citrus3000psi/DCHDMI-Hardware/MainPCB/revision 1.3a/Printing Print Schematic.pdf

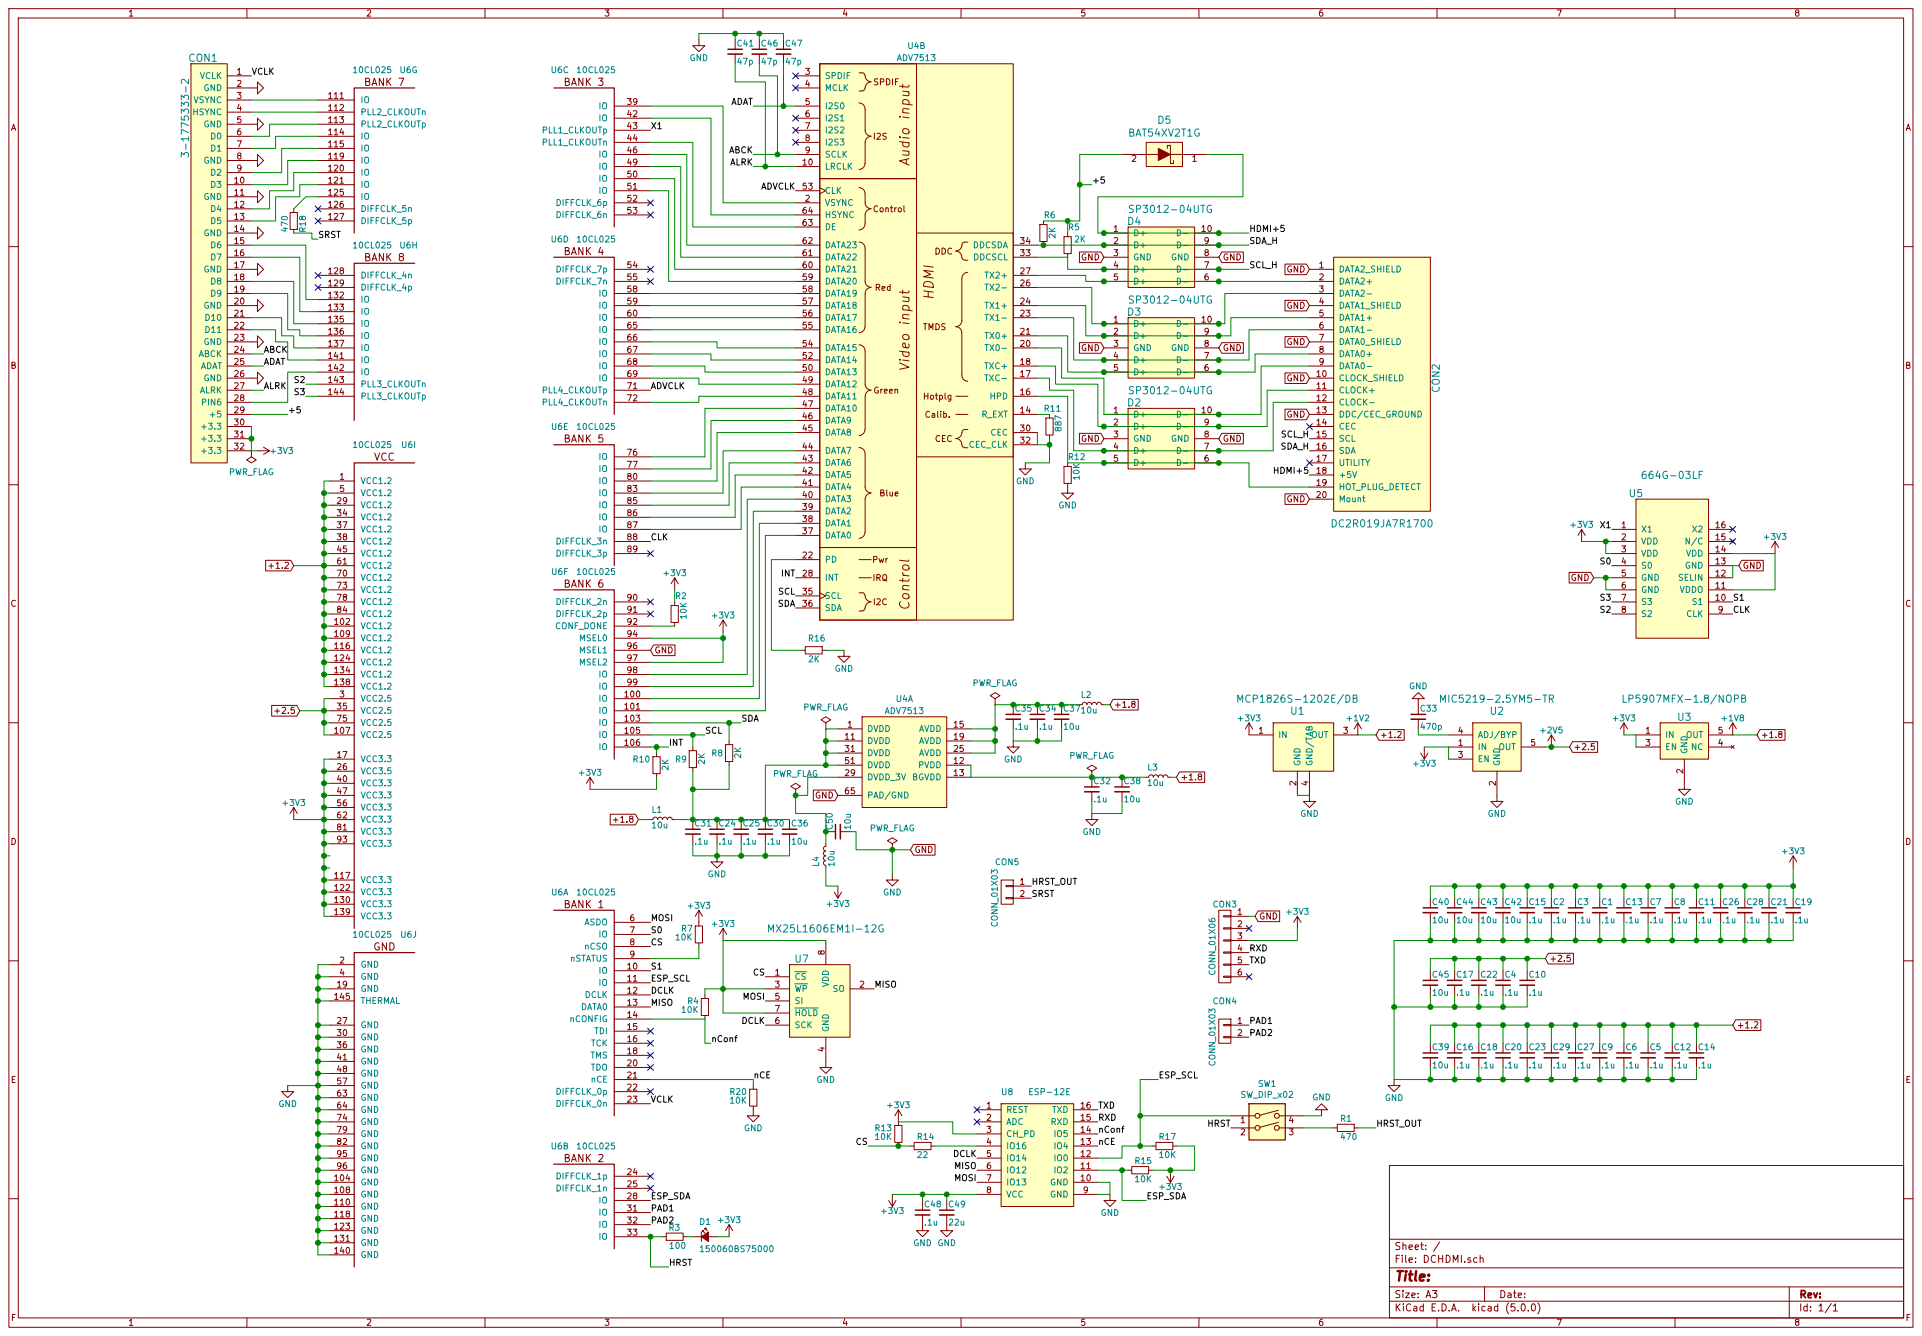
[picture p1: page 1]
