citrus3000psi/DCHDMI-Hardware/FlatFlexQSB/dcflex.kicad_pcb

## KiCad design FlatFlexQSB/dcflex.kicad_pcb (2019-04-15)

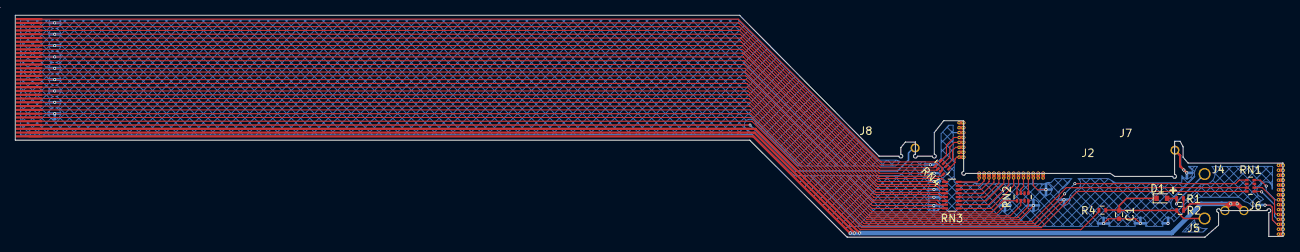
[picture p2: board dcflex.kicad_pcb from above]

Board: 2 copper layers, 167.6 x 29.3 mm, 17 parts (0 on the bottom side), 42 nets.

Parts:
C1: .1u; C_0402
D1: 1N4148WT; D_SOD-523
J1: Conn_01x32_Male; DC_FLEX_FFC_CON
J2: Conn_01x22_Male; DC_FLEX_VIDEO_HOOKUP
J3: Conn_01x15_Male; DC_FLEX_AUDIO_HOOKUP
J4, J5, J7, J8: Conn_01x01_Female; DC-PIN6-PIN7
J6: Conn_01x02_Female; DC-3v3_power
R1, R2: 47K; R_0402
R4: 1K; R_0402
RN1, RN2, RN4: R_Pack04; R_Array_Concave_4x0402
RN3: R_Pack08; R_Array_Convex_8x0602

Connections:
/+3.3: J1.30, J1.31, J1.32, J6.1, J6.2, R1.1, R2.1
/+5: J1.29, J8.1
/ABCK: J1.24, RN1.3
/ADAT: J1.25, RN1.1
/ALRK: J1.27, RN1.4
/D0: J1.6, RN4.8
/D1: J1.7, RN3.1
/D2: J1.9, RN3.2
/D3: J1.10, RN3.3
/D4: J1.12, RN3.4
/D5: J1.13, RN3.5
/D6: J1.15, RN3.6
/D7: J1.16, RN3.7
/D8: J1.18, RN3.8
/D9: J1.19, RN2.1
/D10: J1.21, RN2.2
/D11: J1.22, RN2.4
/HSYNC: J1.4, RN4.6
/VCLK: J1.1, RN4.7
/VSYNC: J1.3, RN4.5
GND: C1.2, J1.2, J1.5, J1.8, J1.11, J1.14, J1.17, J1.20, J1.23, J1.26, J2.3, J2.20, J3.3, J7.1
unnamed: C1.1, D1.1, J5.1, R2.2, R4.1
unnamed: D1.2, J4.1, R1.2
unnamed: J1.28, R4.2
unnamed: J2.4, RN2.5
unnamed: J2.5, RN2.7
unnamed: J2.6, RN2.8
unnamed: J2.7, RN3.9
unnamed: J2.8, RN3.10
unnamed: J2.9, RN3.11
unnamed: J2.10, RN3.12
unnamed: J2.11, RN3.13
unnamed: J2.12, RN3.14
unnamed: J2.13, RN3.15
unnamed: J2.14, RN3.16
unnamed: J2.15, RN4.1
unnamed: J2.17, RN4.2
unnamed: J2.18, RN4.3
unnamed: J2.19, RN4.4
unnamed: J3.4, RN1.5
unnamed: J3.5, RN1.6
unnamed: J3.8, RN1.8
