citrus3000psi/DCHDMI-Hardware/MainPCB/revision 1.2f/DCHDMI.kicad_pcb

## KiCad design MainPCB/revision 1.2f/DCHDMI.kicad_pcb (2018-09-04)

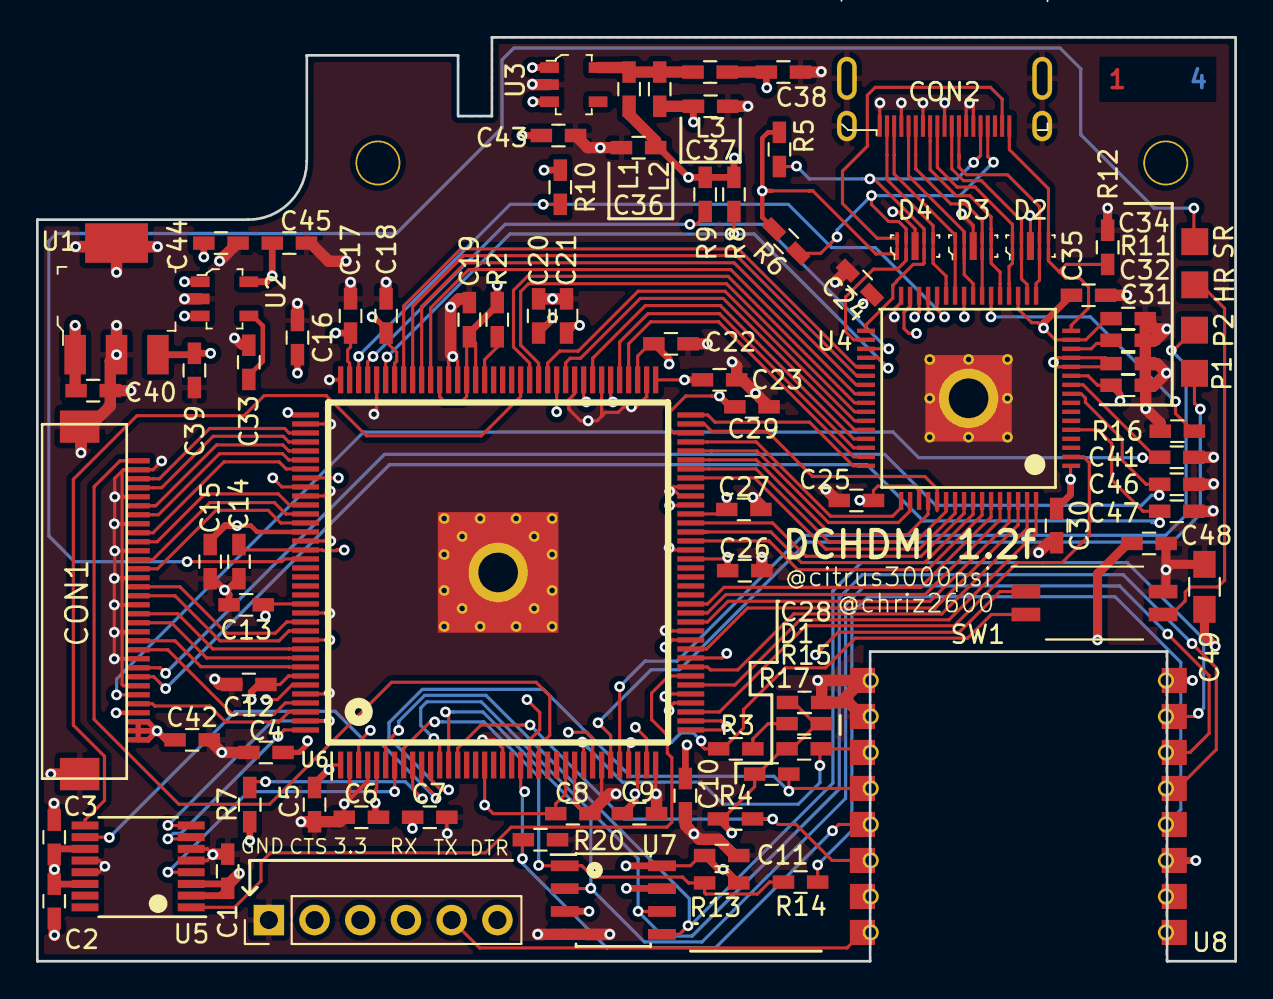
[picture p3: board DCHDMI.kicad_pcb from above]

Board: 4 copper layers, 66.6 x 51.3 mm, 87 parts (0 on the bottom side), 98 nets.

Parts:
C1, C2, C3, C4, C5, C6, C7, C8, C9, C10, C11, C12, C13, C14, C15, C16, C17, C18, C19, C20, C21, C22, C23, C24, C25, C26, C27, C28, C29, C30, C31, C32, C34, C35, C48: .1u; C_0603_HandSoldering
C33: 470p; C_0603_HandSoldering
C36, C37, C38, C39, C40, C42, C43, C44, C45: 10u; C_0603_HandSoldering
C41, C46, C47: 47p; C_0603_HandSoldering
C49: 22u; C_0805_HandSoldering
CON1: 3-1775333-2; FPC_32
CON2: DC2R019JA7R1700
CON3: CONN_01X06; Pin_Header_Straight_1x06_Pitch2.54mm
CON4, CON5: CONN_01X03; 2_Pads_Small
D1: LED; C_0603_HandSoldering
D2, D3, D4: SP3012-04UTG; UFDFN-10_2.5x1mm
L1, L2, L3: 10u; C_0603_HandSoldering
R2, R3, R4, R7, R12, R13, R15, R17, R20: 10K; C_0603_HandSoldering
R5, R6, R8, R9, R10, R16: 2K; C_0603_HandSoldering
R11: 880; C_0603_HandSoldering
R14: 22; C_0603_HandSoldering
SW1: SW_DIP_x02; SW_DIP_x2_W7.62mm_Slide_Copal_CHS-B
U1: MCP1826S-1202E/DB; SOT-223
U2: MIC5219-2.5YM5-TR; SOT-753
U3: LP5907MFX-1.8/NOPB; SOT-753
U4: ADV7513; LQFP-64_10x10mm_Pitch0.5mm_PAD
U5: 664G-03LF; TSSOP-16_4.4x5mm_Pitch0.65mm
U6: 10CL025; altera144_wcenterpad
U7: MX25L1606EM1I-12G; SOIC-8_3.9x4.9mm_Pitch1.27mm
U8: ESP-12E; ESP-12_FLAT

Connections:
+1.2: C5.1, C6.1, C9.1, C12.1, C14.1, C16.1, C18.1, C20.1, C23.1, C27.1, C29.1, C39.1, U1.3, U6.1, U6.5, U6.29, U6.34, U6.37, U6.38, U6.45, U6.61, U6.70, U6.73, U6.78, U6.84, U6.102, U6.109, U6.116, U6.124, U6.134, U6.138
+1.8: L1.1, L2.2, L3.2, U3.5
+2.5: C4.1, C10.1, C17.1, C22.1, C45.1, U2.5, U6.3, U6.35, U6.75, U6.107
+3V3: C1.1, C2.1, C3.1, C7.1, C8.1, C11.1, C13.1, C15.1, C19.1, C21.1, C26.1, C28.1, C40.1, C42.1, C43.1, C44.1, C48.1, C49.1, CON1.30, CON1.31, CON1.32, CON3.3, D1.2, R2.1, R4.1, R7.1, R10.2, R13.1, R15.1, R17.1, U1.1, U2.1, U2.3, U3.1, U3.3, U4.29, U5.2, U5.3, U5.11, U5.14, U6.17, U6.26, U6.40, U6.47, U6.56, U6.62, U6.81, U6.93, U6.94, U6.97, U6.117, U6.122, U6.130, U6.139, U7.3, U7.7, U7.8, U8.3, U8.8
/+5: CON1.29, CON2.18, D4.1, D4.10, R5.1, R6.1
/ABCK: C46.2, CON1.24, U4.9
/ADAT: C47.2, CON1.25, U4.5
/ADVCLK: U4.53, U6.71
/ALRK: C41.2, CON1.27, U4.10
/CLK: U5.9, U6.88
/CS: R13.2, R14.2, U6.8, U7.1
/DCLK: U6.12, U7.6, U8.5
/ESP_SCL: R17.2, SW1.1, U6.11, U8.12
/ESP_SDA: R15.2, U6.28, U8.11
/HRST: R3.1, SW1.2, U6.33
/HRST_OUT: CON5.1, SW1.3
/INT: R10.1, U4.28, U6.106
/MISO: U6.13, U7.2, U8.6
/MOSI: U6.6, U7.5, U8.7
/PAD1: CON4.1, U6.31
/PAD2: CON4.2, U6.32
/RXD: CON3.4, U8.15
/S0: U5.4, U6.7
/S1: U5.10, U6.10
/S2: U5.8, U6.143
/S3: U5.7, U6.144
/SCL: R9.1, U4.35, U6.105
/SCL_H: CON2.15, D4.4, D4.7, R5.2, U4.33
/SDA: R8.1, U4.36, U6.103
/SDA_H: CON2.16, D4.2, D4.9, R6.2, U4.34
/SRST: CON5.2, U6.125
/TXD: CON3.5, U8.16
/VCLK: CON1.1, U6.23
/X1: U5.1, U6.43
/nCE: R20.1, U6.21, U8.13
/nConf: R4.2, U6.14, U8.14
GND: C1.2, C2.2, C3.2, C4.2, C5.2, C6.2, C7.2, C8.2, C9.2, C10.2, C11.2, C12.2, C13.2, C14.2, C15.2, C16.2, C17.2, C18.2, C19.2, C20.2, C21.2, C22.2, C23.2, C24.2, C25.2, C26.2, C27.2, C28.2, C29.2, C30.2, C31.2, C32.2, C33.1, C34.2, C35.2, C36.2, C37.2, C38.2, C39.2, C40.2, C41.1, C42.2, C43.2, C44.2, C45.2, C46.1, C47.1, C48.2, C49.2, CON1.2, CON1.5, CON1.8, CON1.11, CON1.14, CON1.17, CON1.20, CON1.23, CON1.26, CON2.1, CON2.4, CON2.7, CON2.10, CON2.13, CON2.14, CON2.20, CON3.1, D2.3, D2.8, D3.3, D3.8, D4.3, D4.8, R11.2, R12.2, R16.1, R20.2, SW1.4, U1.2, U1.4, U2.2, U3.2, U4.30, U4.32, U4.65, U5.5, U5.6, U5.12, U5.13, U6.2, U6.4, U6.19, U6.27, U6.30, U6.36, U6.41, U6.48, U6.57, U6.63, U6.64, U6.74, U6.79, U6.82, U6.95, U6.96, U6.104, U6.108, U6.110, U6.118, U6.123, U6.131, U6.140, U6.145, U7.4, U8.9, U8.10
unnamed: C24.1, C25.1, C30.1, C31.1, C36.1, L1.2, R8.2, R9.2, U4.1, U4.11, U4.31, U4.51
unnamed: C32.1, C38.1, L3.1, U4.12, U4.13
unnamed: C33.2, U2.4
unnamed: C34.1, C35.1, C37.1, L2.1, U4.15, U4.19, U4.25
unnamed: CON1.3, U6.111
unnamed: CON1.4, U6.112
unnamed: CON1.6, U6.113
unnamed: CON1.7, U6.114
unnamed: CON1.9, U6.115
unnamed: CON1.10, U6.119
unnamed: CON1.12, U6.120
unnamed: CON1.13, U6.121
unnamed: CON1.15, U6.132
unnamed: CON1.16, U6.133
unnamed: CON1.18, U6.135
unnamed: CON1.19, U6.136
unnamed: CON1.21, U6.137
unnamed: CON1.22, U6.141
unnamed: CON1.28, U6.142
unnamed: CON2.2, D4.5, D4.6, U4.27
unnamed: CON2.3, D3.1, D3.10, U4.26
unnamed: CON2.5, D3.2, D3.9, U4.24
unnamed: CON2.6, D3.4, D3.7, U4.23
unnamed: CON2.8, D3.5, D3.6, U4.21
unnamed: CON2.9, D2.1, D2.10, U4.20
unnamed: CON2.11, D2.2, D2.9, U4.18
unnamed: CON2.12, D2.4, D2.7, U4.17
unnamed: CON2.19, D2.5, D2.6, R12.1, U4.16
unnamed: D1.1, R3.2
unnamed: R2.2, U6.92
unnamed: R7.2, U6.9
unnamed: R11.1, U4.14
unnamed: R14.1, U8.4
unnamed: R16.2, U4.22
unnamed: U4.2, U6.39
unnamed: U4.37, U6.101
unnamed: U4.38, U6.100
unnamed: U4.39, U6.99
unnamed: U4.40, U6.98
unnamed: U4.41, U6.87
unnamed: U4.42, U6.86
unnamed: U4.43, U6.85
unnamed: U4.44, U6.83
unnamed: U4.45, U6.80
unnamed: U4.46, U6.77
unnamed: U4.47, U6.76
unnamed: U4.48, U6.72
unnamed: U4.49, U6.69
unnamed: U4.50, U6.68
unnamed: U4.52, U6.67
unnamed: U4.54, U6.66
unnamed: U4.55, U6.65
unnamed: U4.56, U6.60
unnamed: U4.57, U6.59
unnamed: U4.58, U6.58
unnamed: U4.59, U6.51
unnamed: U4.60, U6.50
unnamed: U4.61, U6.49
unnamed: U4.62, U6.46
unnamed: U4.63, U6.44
unnamed: U4.64, U6.42
