citrus3000psi/DCHDMI-Hardware/(threads)

Thread 2 (2018-07-23):

BOM

Uplinkpro, 2018-07-23:
Any change for a BOM soon? The Kicad BOM output is very vague.

citrus3000psi, 2019-04-15:
What questions do you have about it?  I did not list specific part numbers for caps or resistors as many go out of stock etc.

Closed 2019-04-15.

Thread 3 (2018-12-08):

Flex cable

toto99303, 2018-12-08:
Hello, are you planning to upload the flex cable design? Thanks!

Closed 2019-04-15.

Thread 4 (2018-12-18):

DCHDMI nukes whole HDMI Control (HDMI-CEC) network

ACiDxCHRiST, 2018-12-18:
As soon as the HDMI cable is attached to the Dreamcast, the whole HDMI-CEC network goes down. Devices are not able to identify each other (ie. Receiver and TV), button presses on one device's remote are not transferred to the other devices in the chain (ie. changing Receiver volume with TV remote), Standby Sync does not function (ie. Turning on/off Receiver+Android TV Box automatically when TV is turned on/off or any other combination depending on which device is turned on/off), and Automatic Input Switching does not function (ie. Receiver automatically changes to Android TV input when Android TV box is powered on.)

It does not matter if the Dreamcast is powered or not, simply making the mechanical connection takes the whole network down. I initially noticed this with my default setup which is with a single HDMI cable from the output of the Receiver to an input on the TV. Six other HDMI Devices + the Dreamcast are connected to the seven inputs of my receiver. I then tested it with an abbreviated network using just the TV (to rule out any weirdness that might be specific to my Receiver). NVIDIA Shield TV connected to Input 1 of the TV and a 2nd HDMI cable connected to Input 2 of the TV. I verified that all the HDMI-CEC functions listed above worked (ie. Standby Sync, Volume Control, Navigating Android TV interface with TV Remote etc.). As soon as I connected the 2nd HDMI cable to the Dreamcast, all HDMI-CEC functionality ceased between the NVIDIA Shield TV and the TV. And interesting to note, as soon as I disconnected the HDMI cable from the Dreamcast, all of the "Up, Down, Left, Right" button presses that I had done on the TV Remote, suddenly played back rapidly in order on the Android TV interface.

I should also mention that this does not appear to effect HDMI Video/Audio or metadata transmission. Also of note, I have an N64 UltraHDMI that does not cause any issues like this.

Other Details:
TV: Samsung Q6FN
DCHDMI: Install done by citrus3000psi (VA1, USB-GDROM with Reset)

citrus3000psi, 2018-12-18:
Thanks for pointing this issue out.  The CEC pin on the HDMI grounded and is what is causing these problems.  There are three ways to fix, ranging from hardest to easiest.

-Remove the HDMI connector and cut the trace to CEC and Reinstall HDMI connector (not recommended)
-Lift pin 14 on the HDMI connector.  Difficult to do, but is possible.
-Purchase a CEC Less Adapter like this one:  https://www.amazon.com/Lindy-HDMI-Adapter-Female-41232/dp/B00DL48KVI/

All future revisions will not have this issue.  Sorry for any inconvenience everybody.

ACiDxCHRiST, 2018-12-18:
I went ahead and ordered the CEC Less Adapter, but reading through the reviews for the product and then researching the HDMI pinout, it looks like CEC is on Pin 13. You mentioned lifting Pin 14 on the connector; so I just wanted to confirm, do you lift Pin 13 or 14 on the connector? (if you wanted to use that method)

mario-64, 2018-12-27:
I can confirm the CEC-less adapter resolves the issue. As a workaround I mean.

Closed 2019-04-15.

Thread 5 (2019-04-16):

Details on flex PCB

wmi-0, 2019-04-16:
First of all a huge thanks for releasing the DCHDMI hardware designs as open source!

Can you provide some details on how the flex cable should be manufactured?
From the connector I assume 0.3mm thickness ~~0.1mm thickness with a 0.2mm plastic stiffener on the bottom~~, 0.5 oz copper?

citrus3000psi, 2019-04-18:
The FFC connector needs to be ~.3mm   I get the flex made in .18mm with the stiffener at .1mm  With the adhesive its a shy over .3mm

.5oz copper works, but the place I uses offers 1oz at no extra cost so I always choose that

Closed 2019-04-18.

Thread 6 (2020-06-27):

A slight misalignment of the dc digital board to the left will cause a short when closing back the shielding

mathieulh, 2020-06-27:
A slight misalignment of the dc digital board to the left (about a degree or less) will cause a short when closing back the shielding, no amount of isolation will fix it (I literally taped the board at one point), the short will cause PSUs without protections (including the original one) to eventually start sparking, then burning. (yes, this happened to me!) Realigning the board fixed it, but this design makes it literally a fire harzard if the install is slightly off (we are talking a degree or less shift to the left). Fortunately for me the Pico PSU I usually use has protections against short or things could have gone really bad, the original PSU sparked all over and had a very bad burnt smell when I tried it for less than 2 seconds.

citrus3000psi, 2020-06-28:
Can you confirm the vinyl backing is covering up the esp2866 WiFi solder points. One of the two bottom points is 3.3v and if not properly isolated then a direct short can happen.

citrus3000psi, 2020-06-28:
I just relooked at this. There is nothing remotely close to touching the board in either direction.

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

mathieulh, 2020-07-01:
Sorry for the late reply, yes I can confirm the vinyl is on, I also looked and did not see anything that did contact myself, I even taped the whole board, the only thing I can think of is the screw itself. Whenever it was shifted to the left it caused a short.

citrus3000psi, 2020-07-01:
Your cause is likely from not reinstalling the plastic protector piece under the PSU when using the original.

"the original PSU sparked all over and had a very bad burnt smell when I tried it for less than 2 seconds."

Its impossible for the PSU to spark on the secondary side as this would have never been allowed in Europe, even in 1998.  The PSU has a built in fuse which wouldn't allow this.  It appears your primary side (240v) shorted because of the missing plastic piece that goes under the PSU.  This has happened to other users as well.

mathieulh, 2020-07-01:
The plastic was below the PSU, I also tested a pico psu (that's what I used originally), and it detected the short (and would cut power to the board), whereas the fuse on the PSU did not trigger (I was using a 220V PSU if tthat information helps).

citrus3000psi, 2020-07-01:
If the primary side of the PSU shorted, than it could cause all sorts of havok in the system so after switching to the Pico, the damage was already done.

Again, Its impossible for the PSU to short on the secondary side and throw sparks.  This is something the DCHDMI could not have caused no matter what.  And out of the 1500 installs, you happen to the be the only one.  If the unit only need to be barely moved and it would blow the system there would be numerous reports.

And to restate the fact there is an image with the DCHDMI board showing it cannot short against anything.

mathieulh, 2020-07-01:
All I can tell is the short happened, I am not going to cause it on purpose for obvious reasons. The part of the PSU that had the burnt smell was the bottom part (the one closest to the power button). Again, the plastic part was definitely under the PSU, heck I put it even when I use the pico psu even though that's typically useless.

I suspect one of the mounting screws may have caused the short.

Closed 2020-07-01.
