citrus3000psi/DCHDMI-Hardware/(commit log)

2018-03-27 Added Project Files
    [BOM.xlsx, DCHDMI.kicad_pcb, DCHDMI.sch]
2018-03-27 Clean Up
    [BOM.xlsx, DCHDMI.kicad_pcb, DCHDMI.sch]
2018-04-05 Added 1.2a
    [DCHDMI.kicad_pcb, DCHDMI.sch]
2018-04-05 Added BOM
    [BOM.xlsx]
2018-04-23 Added 1.2b
    [DCHDMI.kicad_pcb, DCHDMI.sch]
2018-04-26 Added 1.2c
    [DCHDMI.kicad_pcb, DCHDMI.sch]
2018-05-01 Added 1.2d
    [BOM.xlsx, DCHDMI.kicad_pcb, DCHDMI.sch]
2018-07-05 4 layer version
    [DCHDMI.kicad_pcb]
2018-07-05 solve silkscreen issues introduced with 4 layer version
    [DCHDMI.kicad_pcb]
2018-07-06 Increased version number
    [DCHDMI.kicad_pcb]
2018-07-06 Increased version
    [DCHDMI.kicad_pcb, DCHDMI.sch]
2018-07-16 Minor Update to Edge Cuts
    [DCHDMI.kicad_pcb, DCHDMI.sch]
2018-07-17 Edge Cuts Again
    [DCHDMI.kicad_pcb]
2018-08-16 Added ESP FTDI Header
    [DCHDMI.kicad_pcb, DCHDMI.sch]
2018-09-04 1.2 Revison
    JTAG replaced with ESP header. In Game Reset Pads added.
    [DCHDMI.kicad_pcb, DCHDMI.sch]
2018-09-05 Added 470 series resistor
    [DCHDMI.kicad_pcb, DCHDMI.sch]
2018-09-06 Fixed Issue
    [DCHDMI.kicad_pcb, DCHDMI.sch]
2018-12-21 updated to 1.3a
    [DCHDMI.csv, DCHDMI.kicad_pcb, DCHDMI.sch]
2019-04-15 Added Flex Design
    [DCFlex1.2_BOM.csv, dcflex.kicad_pcb, dcflex.sch]
